JS2028EE/ESP32-Based-Wireless-Embedded-Control-System-for-a-Dual-Motor-Robotic-Vehicle/images/IMG_6735.jpeg

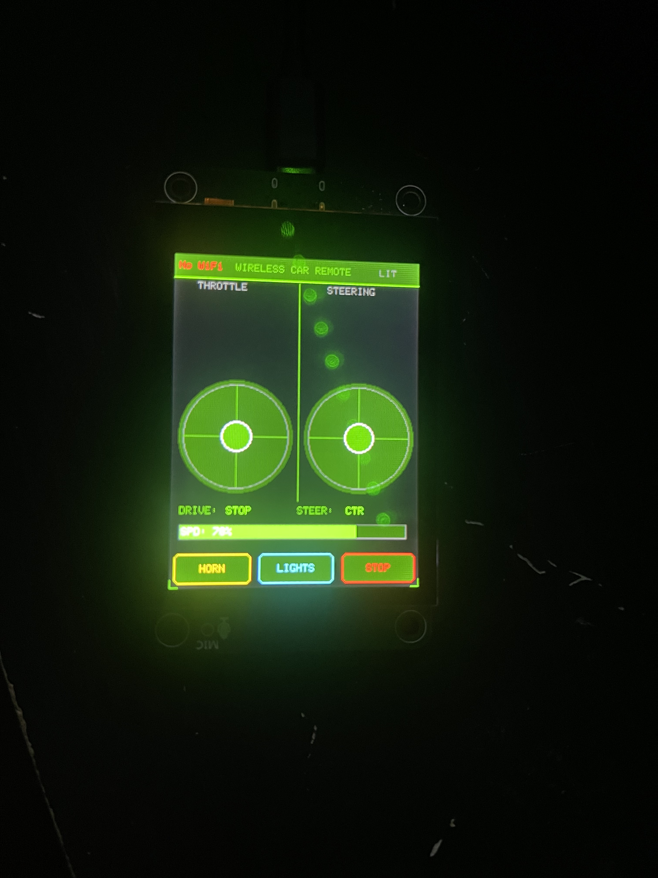
images/IMG_6735.jpeg
