JS2028EE/ESP32-Based-Wireless-Embedded-Control-System-for-a-Dual-Motor-Robotic-Vehicle/Block Diagrams/ESP32-CAR_BD.png

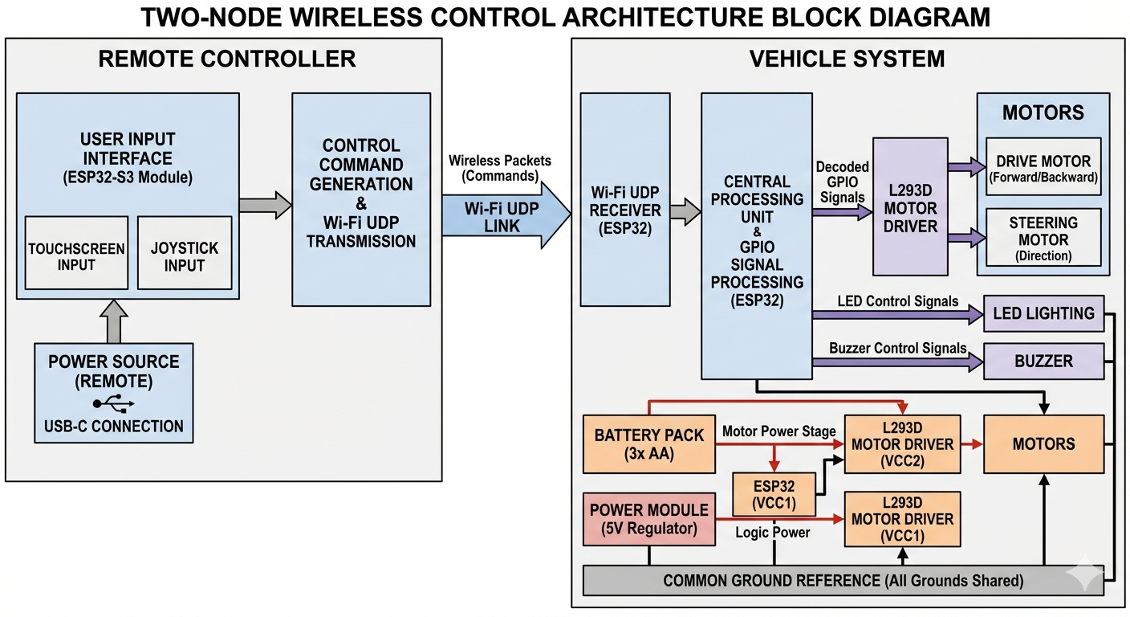
Block Diagrams/ESP32-CAR_BD.png
