JS2028EE/ESP32-Based-Wireless-Embedded-Control-System-for-a-Dual-Motor-Robotic-Vehicle/Block Diagrams/Software Block diagram.png

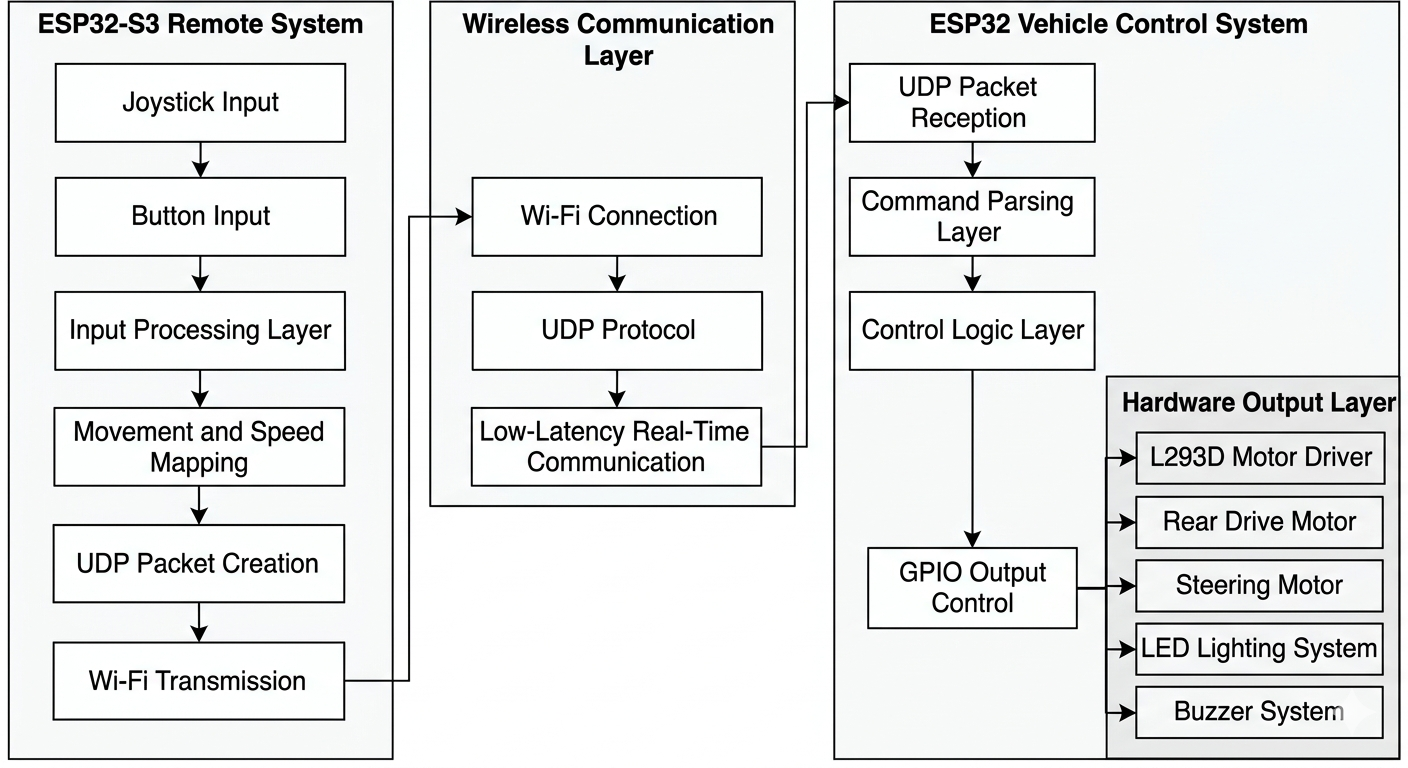
Block Diagrams/Software Block diagram.png
