JS2028EE/ESP32-Based-Wireless-Embedded-Control-System-for-a-Dual-Motor-Robotic-Vehicle/schematics/Buzzer Schematic.jpeg

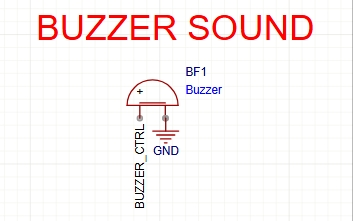
schematics/Buzzer Schematic.jpeg
