JS2028EE/ESP32-Based-Wireless-Embedded-Control-System-for-a-Dual-Motor-Robotic-Vehicle/schematics/ESP32 Schematic.jpeg

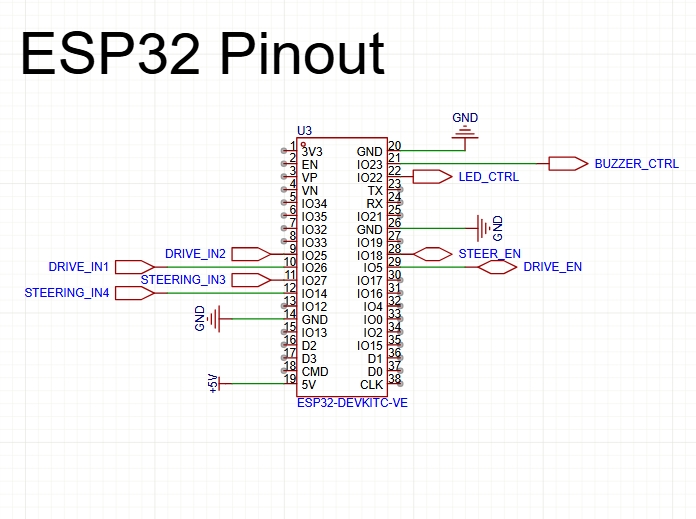
schematics/ESP32 Schematic.jpeg
