JS2028EE/ESP32-Based-Wireless-Embedded-Control-System-for-a-Dual-Motor-Robotic-Vehicle/schematics/L293D Schematic.jpeg

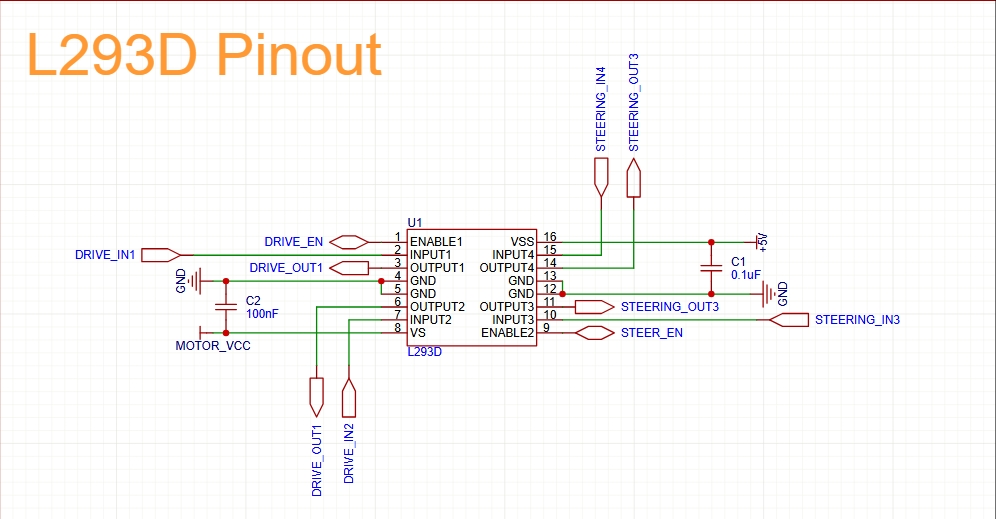
schematics/L293D Schematic.jpeg
