JS2028EE/ESP32-Based-Wireless-Embedded-Control-System-for-a-Dual-Motor-Robotic-Vehicle/schematics/LED Indicator Schematic.jpeg

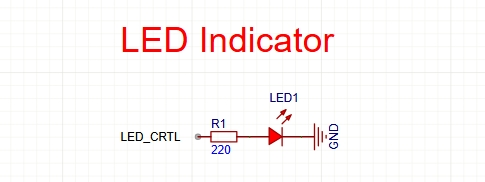
schematics/LED Indicator Schematic.jpeg
