JS2028EE/ESP32-Based-Wireless-Embedded-Control-System-for-a-Dual-Motor-Robotic-Vehicle/schematics/Motors Schematic.jpeg

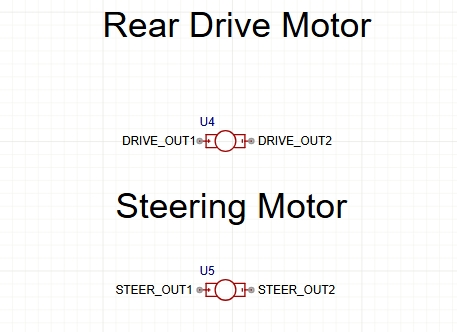
schematics/Motors Schematic.jpeg
