JS2028EE/ESP32-Based-Wireless-Embedded-Control-System-for-a-Dual-Motor-Robotic-Vehicle/(commit log)

2026-05-23 Add ESP32 vehicle controller code
    Initial implementation of ESP32 RC car controller with WiFi AP and UDP server functionality.
2026-05-23 Add new schematic file
2026-10-06 Add control refresh and motor link timeout; document build and license
